praveen-chilamakuri/Ultra-Low-Power-Wearable-Project/Docs/hardware/Hardware system Overview before connections.jpeg

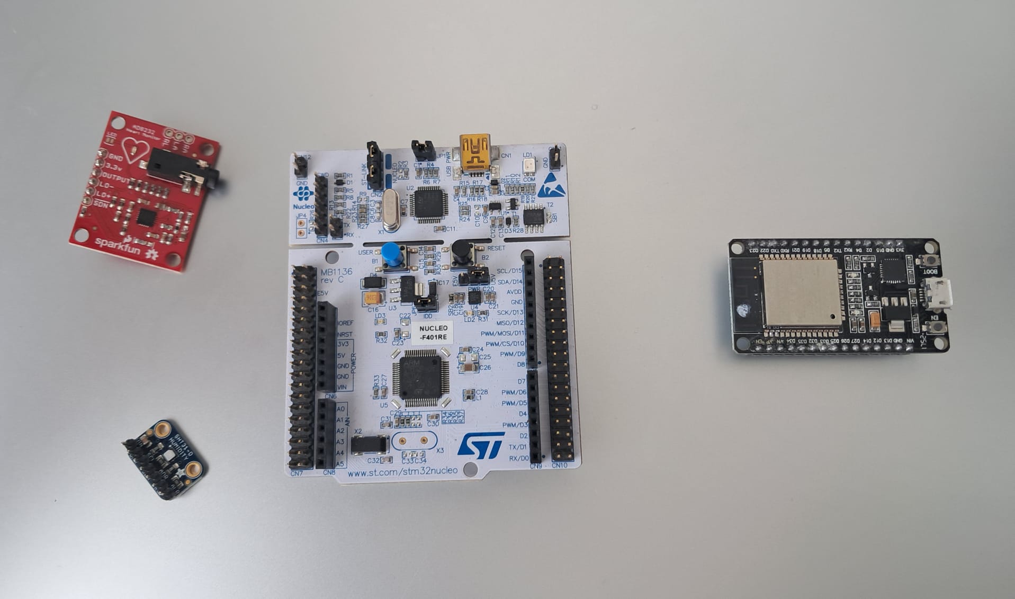
Docs/hardware/Hardware system Overview before connections.jpeg
