praveen-chilamakuri/Ultra-Low-Power-Wearable-Project/Docs/hardware/Hardware system Overview after connections.jpeg

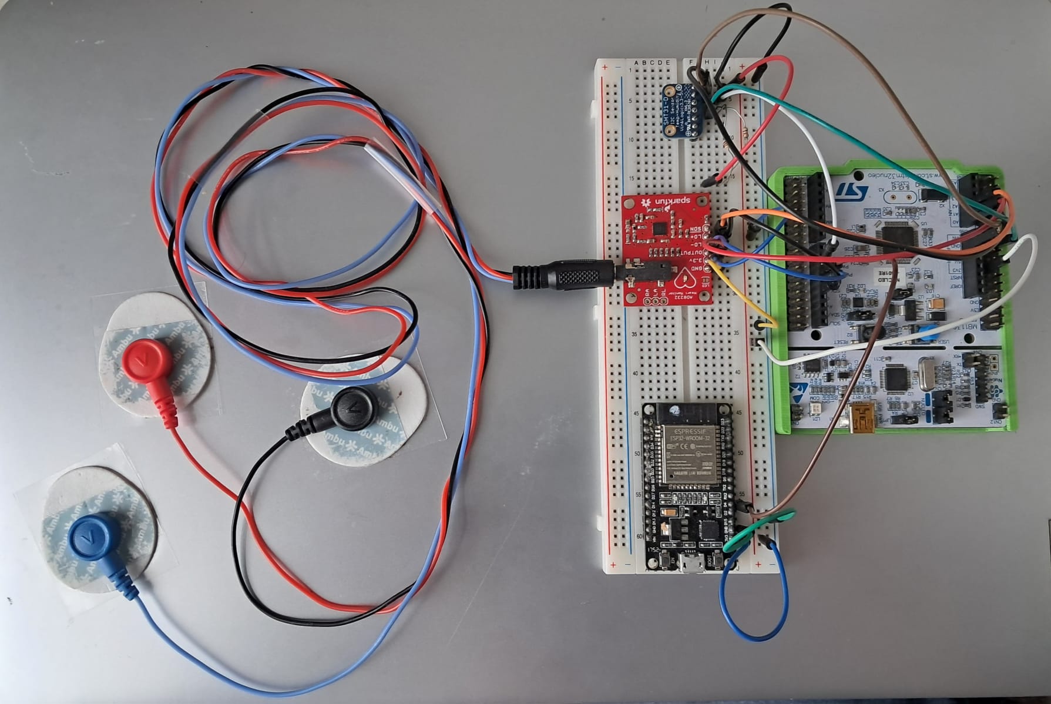
Docs/hardware/Hardware system Overview after connections.jpeg
