praveen-chilamakuri/Ultra-Low-Power-Wearable-Project/Docs/architecture & execution/SYSTEM ARCHITECTURE & EXECUTION FLOW.docx

SYSTEM ARCHITECTURE FLOW:

AD8232 ECG SENSOR

+ → STM32F401RE → ALERT → ESP32 → BLE → USER

SHT31 TEMP SENSOR

SYSTEM EXECUTION FLOW:

Overview:

[Stop] → [Wake] → [Measure] → [Process] → [BLE Alert?] → [Stop]

[STEP 1] [STEP 2 and STEP 3] [STEP 4]

STEP 1:

1. RTC time-out wakes-up the MCU (STM32) from STOP mode
2. RTC timer resets to 7 seconds
3. Proceeds to STEP 2

STEP 2:

1. SHT31, AD8232 both powered ON by MCU GPIO pins
2. Measurement command for only temperature is sent to SHT31 by MCU
3. MCU sleeps while SHT31 measurement is in progress
4. MCU wakes-up after measurement is done, process it, calculates the temperature
5. Checks the threshold
a. If exceeds, alert 1 flag is set
b. Else, no flag for alert 1
6. Only SHT31 is powered OFF by MCU GPIO pin
7. Proceeds to STEP 3

STEP 3:

1. Since AD8232 needs a 150ms stabilisation time before its first accurate measurement, it was powered ON through its SDN pin along with SHT31 and stays idle while SHT31 complete its task and for the time remaining to stabilise, the MCU stays in Sleep mode again
2. After stabilisation, MCU checks the leads OFF status
a. If leads are OFF, alert 2 flag is set and the execution SKIPS to Alert function (STEP 4)
b. Else, no flag for alert 2 and code execution continue for AD8232 measurement
3. ADC sampling for 2 seconds with DMA is enabled, during the time MCU stays in Sleep mode again
4. Filled DMA buffer wakes-up the MCU after which AD8232 is powered OFF through SDN pin of AD8232
5. Buffer data is processed, BPM threshold is checked
a. If exceeds, alert 3 flag is set
b. Else, no flag for alert 3
6. Proceeds to STEP 4

STEP 4:

1. Alert function is being executed
2. Alert flags are checked
a. If either of the three alert flags is set, MCU Set the Alert GPIO pin (that wakes-up the Deep-sleeping ESP32 MCU which enable and transmits the Alert through BLE to the User for a shorter duration of 1.5 second and goes back to deep-sleep mode until woken-up by Alert pin again), MCU De-initialize all the peripherals initialized, Enter STOP mode for the remaining time until RTC timer time-out
b. Else, No change (stays Reset) in the state of Alert GPIO pin (ESP32 stays in Deep-sleep), MCU De-initialize all the peripherals initialized, Enter STOP mode for the remaining time until RTC timer time-out
3. Proceeds to/Starts from STEP 1
