praveen-chilamakuri/Ultra-Low-Power-Wearable-Project/Docs/hardware/CubeMX Pin Configurations.png

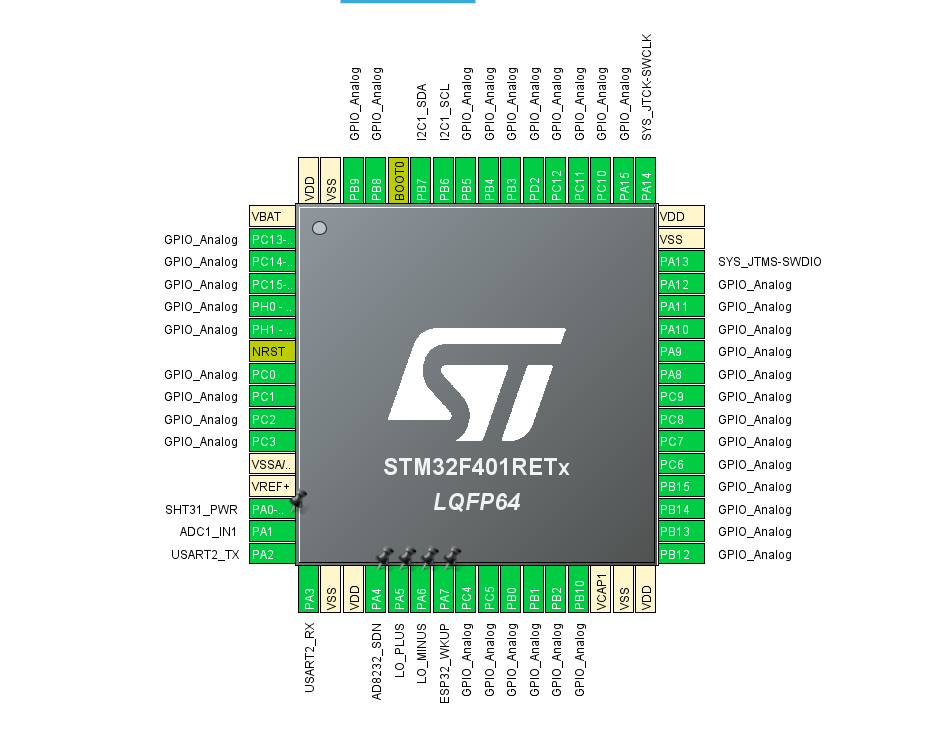
Docs/hardware/CubeMX Pin Configurations.png
