praveen-chilamakuri/Ultra-Low-Power-Wearable-Project/Docs/power_measurements/POWER MEASUREMENT.docx

IDD POWER MEASUREMENT METHODOLOGY:

3.3V External Power Supply

SHT31 Temperature Sensor

ESP32 Wroom-32 Dev-Kit (BLE)

STM32F401RE Nucleo-Board (main MCU)

AD8232 Heart-Rate Sensor

Multimeter in series with STM32 IDD pins to measure the core MCU current

MULTIMETER READINGS:

Ultra-Low-Power-Wearable Project -- Multimeter Measurements (https://1drv.ms/f/c/bc94bdbb4ea6545e/IgBCcq775SYVTJ_lTSFkqnfzAXykbSbgA_POOxDIjo6arJE)
