praveen-chilamakuri/Ultra-Low-Power-Wearable-Project/Docs/results/Current Consumption of the System.docx

1. Operational Lifetime in Existing Devices

Device | Battery Life (Expected on a single AAA battery with continuous monitoring) | Alerts
Google Fitbit | 18 - 20 days | Yes
Hammerhead HRM 2.0 | 100+ days | No
My recommended prototype | 47 - 50 days | Yes

2. Current Consumption of the Prototype

Work Flow of the System | STM32F401RE MCU CORE (Average Current Consumption) | STM32F401RE NUCLEO + ESP32 WROOM32 Dev-Kit (Average Current Consumption (present prototype)) | STM32WB06CC MCU CORE (Average Current Consumption (usage recommended))
Without Alerts | 1.73 – 1.86 mA | 48.94 – 54.21 mA | 0.25 – 0.67 mA (h)
With Alerts | (No inbuilt BLE) | 60.41 – 63.38 mA | 0.65 – 1.02 mA (h)

(h): Hypothetical, STM32WB06CC MCU core datasheet values compared with STM32F401RE MCU core multimeter readings, datasheet values.

Without Alerts:

When the system is working normally and it don’t find any alert flags pending, eliminating the need for the BLE to enable and transmit. This is the state of the system for >98% of its time.

With Alerts:

When the system finds a pending alert flag, it makes the BLE to enable and transmit the alert.

Observation Notes:

- Usage of the Nucleo and the Dev-Kit boards, and their associated onboard/attached hardware components drawing the current is the reason to be considered for such high current draw measurements of the present prototype.
- Though, I have managed to isolate and measure the STM32F401RE MCU core current draw (without alerts) using IDD pins, I did not succeed to measure the current draw during BLE usage (with alerts) as it does not have BLE built-in.
- I searched further for STM32 variants with Low power & BLE built-in features, found STM32WB06CC MCU Core as a better fit for the project design and its usage is recommended.
3. Battery Life Estimation

AAA battery capacity assumed: 800 mAh

Designed System | Average Current Consumption (mA) | Estimated Battery Life (days)
Present Prototype (STM32F401RE + ESP32) | 54.66 mA | 14.6 hours or 0.6 days
Recommended Design (Custom PCB with STM32WB06CC MCU core) | 0.68 mA | 49 days

Result:

Battery life stays within the 45 to 50 day target.
