praveen-chilamakuri/Ultra-Low-Power-Wearable-Project/Docs/results/Serial Monitor Output With Alert (Leads OFF, in this case).png

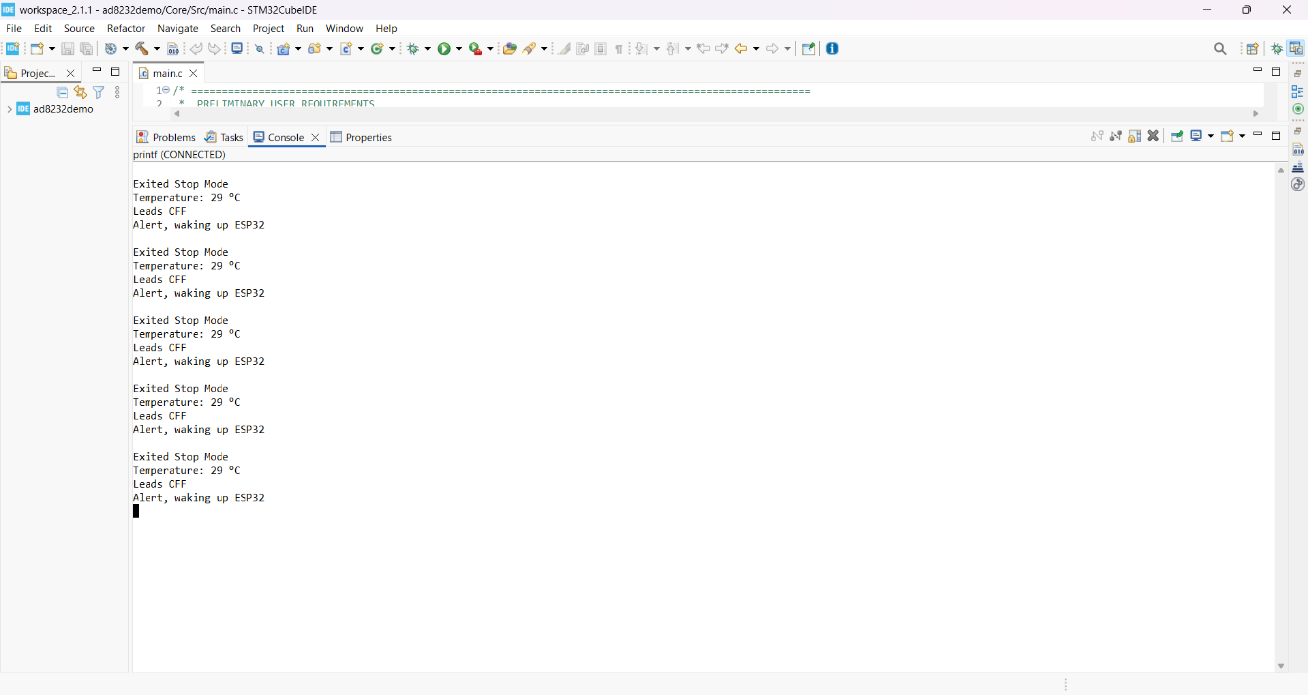
Docs/results/Serial Monitor Output With Alert (Leads OFF, in this case).png
