praveen-chilamakuri/Ultra-Low-Power-Wearable-Project/Docs/results/Serial Monitor Output Without Alert.png

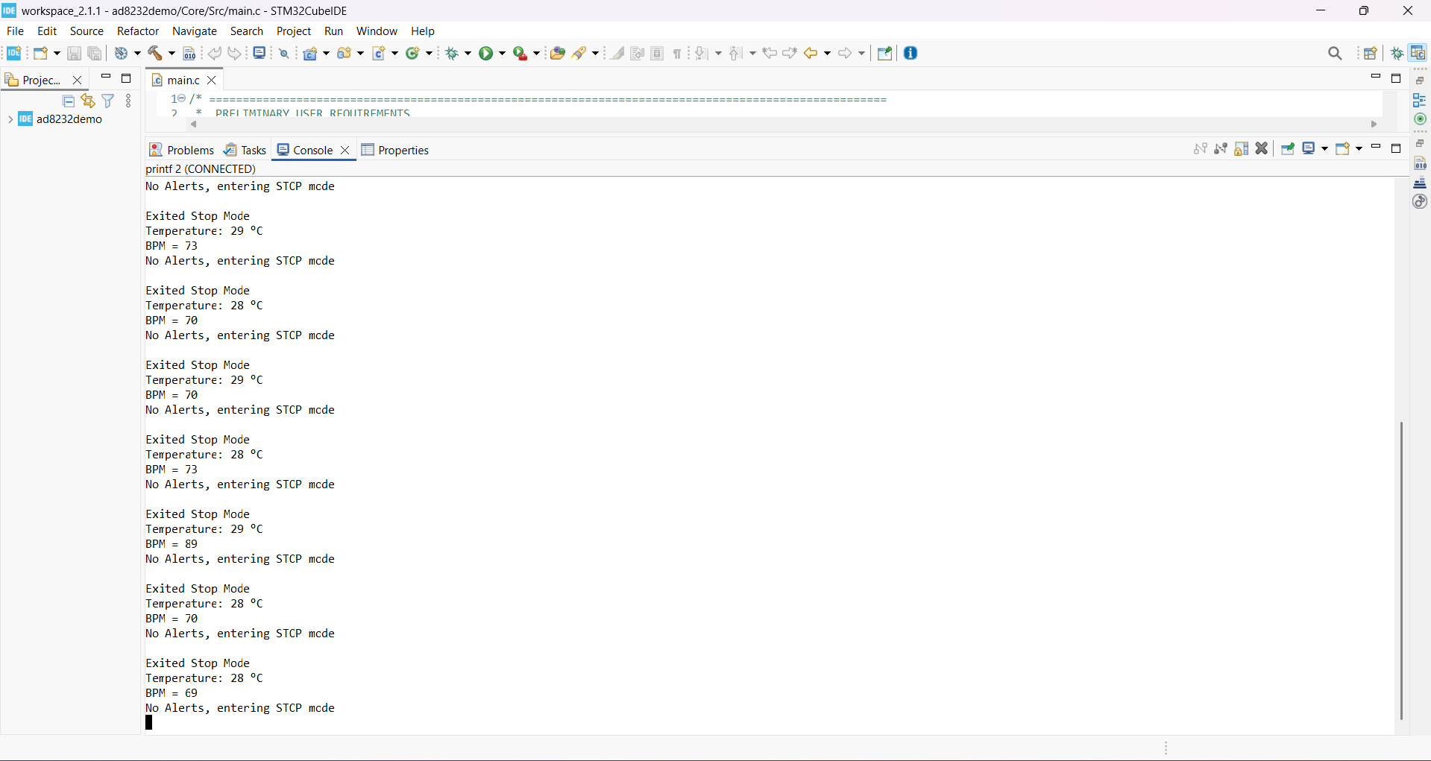
Docs/results/Serial Monitor Output Without Alert.png
