praveen-chilamakuri/Ultra-Low-Power-Wearable-Project/Core/Inc/main.h

#define SHT31_PWR_Pin GPIO_PIN_0
#define SHT31_PWR_GPIO_Port GPIOA
#define AD8232_SDN_Pin GPIO_PIN_4
#define AD8232_SDN_GPIO_Port GPIOA
#define LO_PLUS_Pin GPIO_PIN_5
#define LO_PLUS_GPIO_Port GPIOA
#define LO_MINUS_Pin GPIO_PIN_6
#define LO_MINUS_GPIO_Port GPIOA
#define ESP32_WKUP_Pin GPIO_PIN_7
#define ESP32_WKUP_GPIO_Port GPIOA
