praveen-chilamakuri/Ultra-Low-Power-Wearable-Project/(commit log)

2026-08-06 ESP32 code
2026-08-19 Rename esp32.c to ESP32 Arduino main.c
2026-08-19 Add esp32_main.c file
2026-08-19 seperate folder for ESP32
2026-08-20 Refactor README for improved structure and clarity
    Consolidate hardware specifications and enhance clarity in key low-power techniques. Improve readability of battery lifespan calculations and future development plans.
2026-08-20 Update .gitignore with new ignore patterns
    Added sections for STM32CubeIDE, ESP32 tools, and OS-specific files to .gitignore.
2026-08-20 Simplify system architecture diagram in README
    Removed the detailed subgraphs for sensors, processing, communication, and target node from the diagram.
2026-08-20 Enhance README with sensor nodes and styling
    Added sensor nodes and updated color styles in the diagram.
2026-08-20 Update sensor node diagram in README
    Removed old sensor node diagram and replaced with a simplified version.
2026-08-20 Revise flowchart and add block styling in README
    Updated the flowchart in README.md to reflect changes in the alert system and added color styling for block elements.
2026-08-20 architecture flow svg diagram
2026-08-20 Update README with architecture diagram and details
    Added architecture flow diagram to README and updated hardware architecture section.
2026-08-20 Add center-aligned architecture flow diagram to README
    Updated the README to include an image of the architecture flow diagram with center alignment.
